AU-Eco-Shell-Marathon/BatteryManagementSystem/README.md

# BatteryManagementSystem
A repo with all documentation and src for both old and new versions of the BMS.
