AU-Eco-Shell-Marathon/BatteryManagementSystem/docs/BMS indkøb/readme.txt

Her er dokumenter, hvor der er forsøgt at danne overblik over hvilke komponenter der er taget i brug og hvilke der er på lager / mangler.
Nogle komponenter der er brugt er udgået (obsolete) og disse er der forsøgt at erstatte, det er ikke sikkert at de indkøbte komponenter er passende erstatninger. 

"CompleteBMS... .csv" er indkøbsfilen til farnell med nogle komponenter som kan sendes til værkstedet, hvis disse mangler.
