AU-Eco-Shell-Marathon/BatteryManagementSystem/docs/BAC-projekt_BMSogbatteri_2013_old_documentation/PCB/4_layerPCB AFE and Galv Iso.pdf

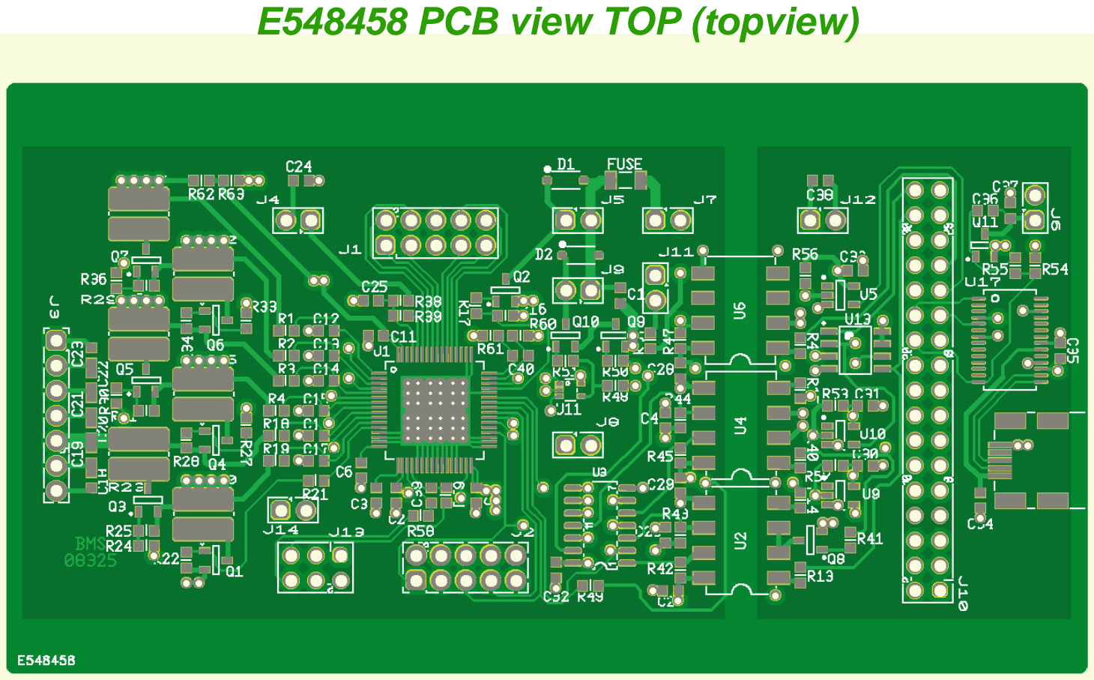
[picture p89: page 1]

E548458 PCB view TOP (topview)

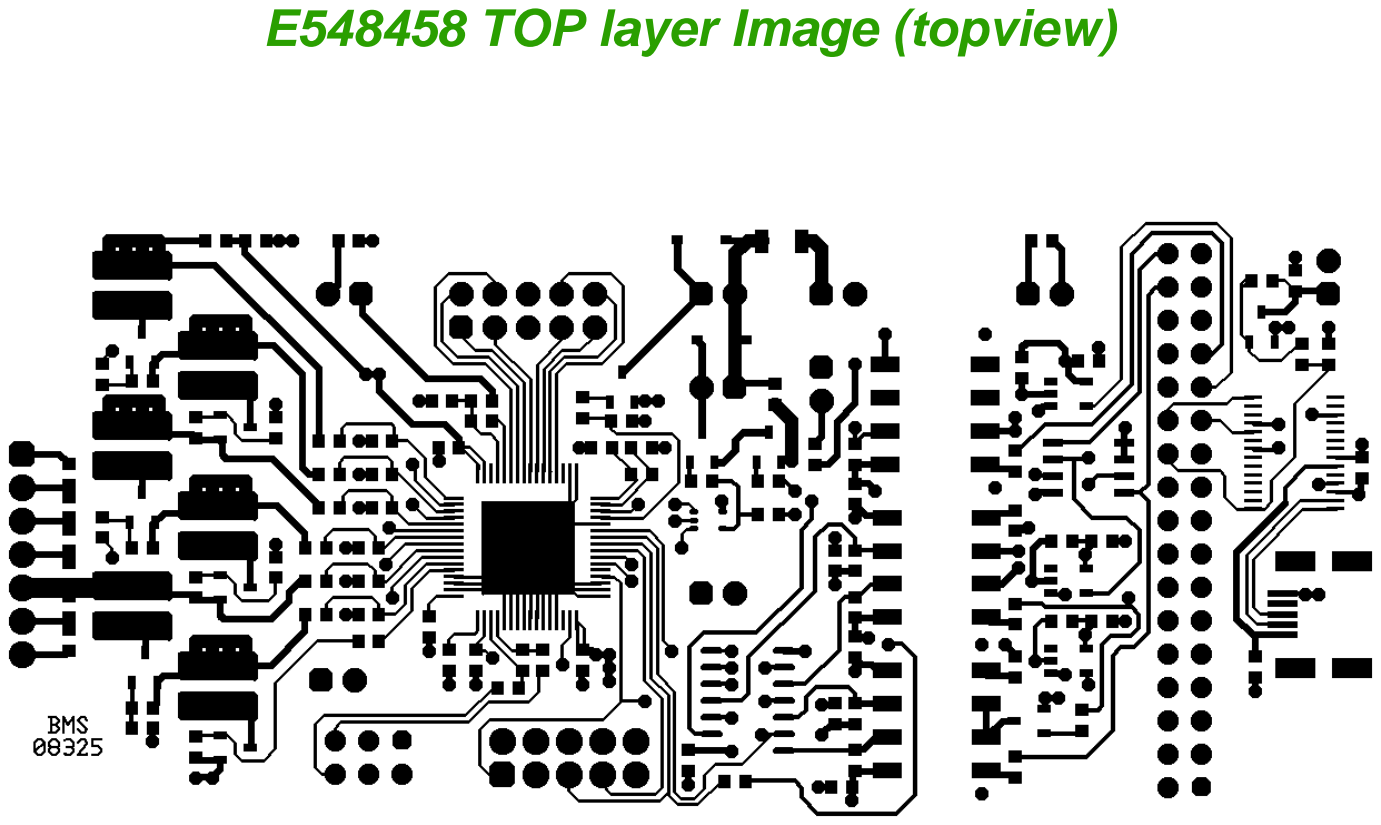
[picture p90: page 2]

E548458 TOP layer Image (topview)

E548458 Innerlayer 2 Image (topview)

E548458 Innerlayer 3 Image (topview)

E548458 BOTTOM layer Image (topview)

E548458 PCB view BOTTOM (bottomview)

# E548458 PCB Mechanical view (topview)

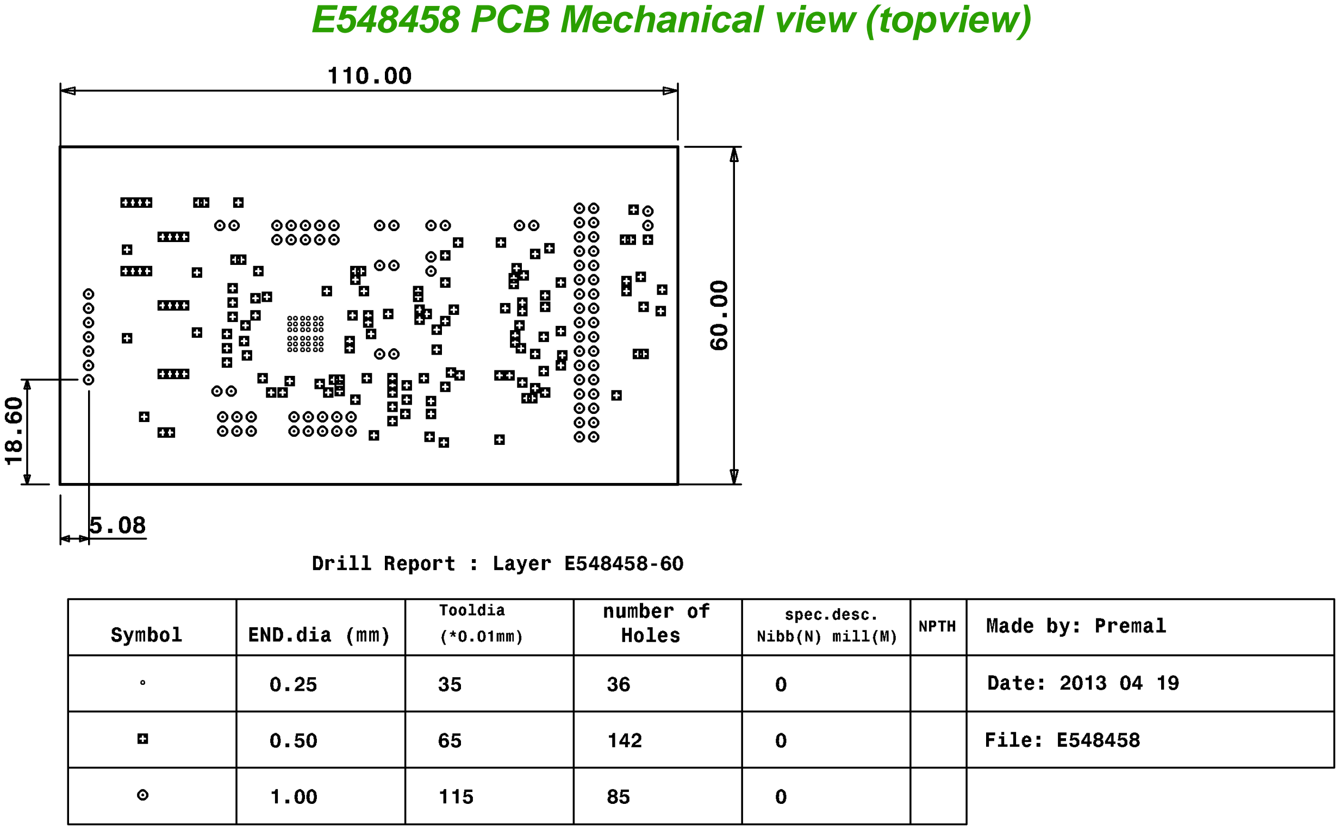
[picture p91: page 7]
