AU-Eco-Shell-Marathon/BatteryManagementSystem/docs/BAC-projekt_BMSogbatteri_2013_old_documentation/Time Management(Gantt Charts)/Gantt Chart ver.4.pdf

ID | Task Name | Start | Finish | Duration | feb 2013 | mar 2013 | apr 2013 | maj 2013 3-2 | 10-2 | 17-2 | 24-2 | 3-3 | 10-3 | 17-3 | 24-3 | 31-3 | 7-4 | 14-4 | 21-4 | 28-4 | 5-5 | 12-5 | 19-5 | 26-5 1 | Specification Requirements | 04-02-2013 | 01-03-2013 | 4w
4 | System Architecture | 18-02-2013 | 19-03-2013 | 4,4w 6 | Rapport summing up all project phases | 18-02-2013 | 10-05-2013 | 12w 7 | 20-03-2013 | 10-05-2013 | 7,6w Implementation of HW including appertaining documentation 9 | Accept test | 10-05-2013 | 10-05-2013 | ,2w 8 | 20-03-2013 | 10-05-2013 | 7,6w Implementation of SW including appertaining documentation

BMS and Propulsion Battery project Gantt Chart
Rev. 4.0 10-05-2013
13 | Finalizing all documentation | 20-05-2013 | 14-06-2013 | 4w 14 | Hand in of project | 14-06-2013 | 14-06-2013 | ,2w
2 | | 20-02-2013 | 01-03-2013 | 1,6w Review of Specification Requirements by external project group and Danish
3 | Technological Institute 5 Accept test document | 11-03-2013 04-03-2013 | 04-04-2013 08-03-2013 | 3,8w Review of System Architecture by external 1w

project group and Danish Technological Institute

## Observe: New hand in date

jun 2013 2-6 | 9-6
10 | 10-05-2013 | 13-05-2013 | ,4w Install BMS in vehicle, perform wiring of electric system, prepare documentation for Shell Eco-marathon 11 | 13-05-2013 | 13-05-2013 | ,2w Design and implement DC/DC converter for solar panels. 12 | Participate in Shell Eco-marathon | 13-05-2013 | 20-05-2013 | 1,2w
