AU-Eco-Shell-Marathon/BatteryManagementSystem/docs/BAC-projekt_BMSogbatteri_2013_old_documentation/Time Management(Gantt Charts)/Gantt Chart ver.2.pdf

ID | Specification Requirements Task Name | 04-02-2013 Start | 01-03-2013 Finish | Duration 4w | feb 2013 10-2 17-2 24-2 3-3 10-3 mar 2013 17-3 24-3 31-3 7-4 apr 2013 14-4 21-4 28-4 5-5 maj 2013 3-2 12-5 19-5 1
2 | | 20-02-2013 | 01-03-2013 | 1,6w Review of Specification Requirements by external project group and Danish
3 | Technological Institute 5 Accept test document | 11-03-2013 04-03-2013 | 15-03-2013 08-03-2013 | 1w Review of System Architecture by external 1w
4 | System Architecture | 18-02-2013 | 19-03-2013 | 4,4w 6 | Rapport summing up all project phases | 18-02-2013 | 10-05-2013 | 12w 7 | 01-04-2013 | 10-05-2013 | 6w Implementation of HW including appertaining documentation 9 | Accept test | 13-05-2013 | 16-05-2013 | ,8w 8 | 01-04-2013 | 10-05-2013 | 6w Implementation of SW including appertaining documentation

BMS and Propulsion Battery project Gantt Chart
Rev. 2.0 03-03-2013
10 | Finalizing all documentation | 14-05-2013 | 27-05-2013 | 2w 11 | Hand in of project | 29-05-2013 | 29-05-2013 | ,2w

project group and Danish Technological Institute
