AU-Eco-Shell-Marathon/BatteryManagementSystem/docs/BAC-projekt_BMSogbatteri_2013_old_documentation/Papers and misc/Calibration data.xlsx

Sheet: Sheet1
Discharge sensor Amp.
Measurement No: | Input [mA] | Output [raw ADC value] | med cal
1 | 0 | 10 | 66
2 | 500 | 150
3 | 1000 | 291
4 | 1500 | 436
5 | 2000 | 579
 | 2500 |  | 2590
 | 3000 |  | 3075
 | 4000 |  | 4076
 | 5000 |  | 5066
 | 6000 |  | 6060
 | 8000 |  | 7994
 | 10000 |  | 9920
 | Slope (gain) | 0.2848
 | Intercept (offset) | 8.4
 | 1/Slope | 3.5112
 | Input raw adc | 436
 | Formula | (Input raw-offset)*(1/slope)
 | output mA | 1501.40

Sheet: Sheet2
Charge sensor Amp.
Measurement No: | Input [mA] | Output [raw ADC value]
1 | 0 | 691
2 | 500 | 1033
3 | 1000 | 1350 | 954
4 | 1500 | 1672
5 | 2000 | 2012
 | Slope (gain) | 0.656
 | Intercept (offset) | 695.4
 | 1/Slope | 1.524
 | Input raw adc | 1350
 | Formula ideal | (Input raw-offset)*(1/slope)
 | output mA | 997.56
 | 8 bit formula comparison
 | output mA /gain | 997.866 |  | Konklusion anvend min. 3 decimalers præcision
 | output mA*1 /gain | 9976.104
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
