AU-Eco-Shell-Marathon/BatteryManagementSystem/(commit log)

2016-05-12 First commit with docu and src + gitignore
    [BMS_Config_h.txt, Calibration data.xlsx, CompleteBMSSparePartsSHOPPING.csv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]
2016-05-21 Added relay datasheet
    [Komponenter til rådighed BMS.xlsx]
